zhihuijundexiaomidi/Smart_Cruise_Car/Control_handle/README.txt

20:25 2022/4/17
这是小车的掌心控制代码

14:04 2022/4/18
oled移植成功。但是库不完善，可以后续完善。

19:20 2022/4/18
MPU6050成功移植。硬件iic没有使用成功。可以先试试简单的硬件iic通信。

12:02 2022/4/19
MPU6050欧拉角获取成功，读取速度要快，不然会爆FIFO存储。300ms内
与oled联调测试完毕。

14:51 2022/4/19
硬件框架构建完成。

14:50 2022/4/25
2.4G通信优化移植成功。但是动态长度依旧没有配置成功。由于时间原因。暂不处理，
只配置静态的通信。

9:25 2022/4/27
手柄的通信命令已完成。小车只需检测收到的命令即可。
