zhihuijundexiaomidi/Smart_Cruise_Car/Smart_Cruise_Car.ioc

Mcu.UserName=STM32F103C8Tx
PA0-WKUP.GPIO_Label=TB6612_E1A
PA0-WKUP.Signal=S_TIM2_CH1_ETR
PA1.GPIO_Label=TB6612_E1B
PA1.Signal=S_TIM2_CH2
PA10.GPIO_Label=DEBUG_R
PA10.Signal=USART1_RX
PA11.GPIO_Label=SPI_CE
PA11.Signal=GPIO_Output
PA12.GPIO_Label=SPI_CSN
PA12.Signal=GPIO_Output
PA13.Signal=SYS_JTMS-SWDIO
PA14.Signal=SYS_JTCK-SWCLK
PA15.GPIO_Label=SPI_IRQ
PA15.Signal=GPIO_Input
PA2.Signal=USART2_TX
PA3.Signal=USART2_RX
PA4.Signal=ADCx_IN4
PA5.Signal=ADCx_IN5
PA6.GPIO_Label=motorA_PWM
PA6.Signal=S_TIM3_CH1
PA7.GPIO_Label=motorB_PWM
PA7.Signal=S_TIM3_CH2
PA8.GPIO_Label=steering_engine_PWM
PA8.Signal=S_TIM1_CH1
PA9.GPIO_Label=DEBUG_T
PA9.Signal=USART1_TX
PB0.GPIO_Label=infrared_sensor_left
PB0.Signal=GPXTI0
PB1.GPIO_Label=infrared_sensor_right
PB1.Signal=GPXTI1
PB10.Signal=USART3_TX
PB11.Signal=USART3_RX
PB12.GPIO_Label=TB6612_A1
PB12.Signal=GPIO_Output
PB13.GPIO_Label=TB6612_A0
PB13.Signal=GPIO_Output
PB14.GPIO_Label=TB6612_B1
PB14.Signal=GPIO_Output
PB15.GPIO_Label=TB6612_B0
PB15.Signal=GPIO_Output
PB3.Signal=SPI1_SCK
PB4.Signal=SPI1_MISO
PB5.Signal=SPI1_MOSI
PB6.GPIO_Label=TB6612_E2A
PB6.Signal=S_TIM4_CH1
PB7.GPIO_Label=TB6612_E2B
PB7.Signal=S_TIM4_CH2
PB8.Signal=I2C1_SCL
PB9.Signal=I2C1_SDA
PC13-TAMPER-RTC.GPIO_Label=LED
PC13-TAMPER-RTC.Signal=GPIO_Output
PD0-OSC_IN.Signal=RCC_OSC_IN
PD1-OSC_OUT.Signal=RCC_OSC_OUT
