zhihuijundexiaomidi/Smart_Cruise_Car/Core/Inc/main.h

#define LED_Pin GPIO_PIN_13
#define LED_GPIO_Port GPIOC
#define TB6612_E1A_Pin GPIO_PIN_0
#define TB6612_E1A_GPIO_Port GPIOA
#define TB6612_E1B_Pin GPIO_PIN_1
#define TB6612_E1B_GPIO_Port GPIOA
#define motorA_PWM_Pin GPIO_PIN_6
#define motorA_PWM_GPIO_Port GPIOA
#define motorB_PWM_Pin GPIO_PIN_7
#define motorB_PWM_GPIO_Port GPIOA
#define infrared_sensor_left_Pin GPIO_PIN_0
#define infrared_sensor_left_GPIO_Port GPIOB
#define infrared_sensor_left_EXTI_IRQn EXTI0_IRQn
#define infrared_sensor_right_Pin GPIO_PIN_1
#define infrared_sensor_right_GPIO_Port GPIOB
#define infrared_sensor_right_EXTI_IRQn EXTI1_IRQn
#define TB6612_A1_Pin GPIO_PIN_12
#define TB6612_A1_GPIO_Port GPIOB
#define TB6612_A0_Pin GPIO_PIN_13
#define TB6612_A0_GPIO_Port GPIOB
#define TB6612_B1_Pin GPIO_PIN_14
#define TB6612_B1_GPIO_Port GPIOB
#define TB6612_B0_Pin GPIO_PIN_15
#define TB6612_B0_GPIO_Port GPIOB
#define steering_engine_PWM_Pin GPIO_PIN_8
#define steering_engine_PWM_GPIO_Port GPIOA
#define DEBUG_T_Pin GPIO_PIN_9
#define DEBUG_T_GPIO_Port GPIOA
#define DEBUG_R_Pin GPIO_PIN_10
#define DEBUG_R_GPIO_Port GPIOA
#define SPI_CE_Pin GPIO_PIN_11
#define SPI_CE_GPIO_Port GPIOA
#define SPI_CSN_Pin GPIO_PIN_12
#define SPI_CSN_GPIO_Port GPIOA
#define SPI_IRQ_Pin GPIO_PIN_15
#define SPI_IRQ_GPIO_Port GPIOA
#define TB6612_E2A_Pin GPIO_PIN_6
#define TB6612_E2A_GPIO_Port GPIOB
#define TB6612_E2B_Pin GPIO_PIN_7
#define TB6612_E2B_GPIO_Port GPIOB
