zhihuijundexiaomidi/Smart_Cruise_Car/user/BSP/bsp_motor.c

#include "bsp_motor.h"  
#include "bsp_SG90.h"  
#include "bsp_encoder.h" 

int base_speed = 1000;
#define left_fix_speed 0
#define right_fix_speed 0
#define turn_fix_speed	60//转弯速度不够快。会跑出轨道

void forward_run(int TargetVelocity,int TargetCircle)
{
	F_RUN;
	steering_engine_PWM(950);//中间右极致
	PID_SET_SPEED(TargetVelocity,TargetCircle);
	left_wheel_speed(base_speed+left_fix_speed);
	right_wheel_speed(base_speed+right_fix_speed);
}

void back_run(int TargetVelocity,int TargetCircle)
{
	B_RUN;
	steering_engine_PWM(950);//中间右极致
	PID_SET_SPEED(TargetVelocity,TargetCircle);
	left_wheel_speed(base_speed+left_fix_speed);
	right_wheel_speed(base_speed+right_fix_speed);
}

void left_run(int TargetVelocity,int TargetCircle)
{
	LB_RUN;
	RF_RUN;
	steering_engine_PWM(600);//右极致
	PID_SET_SPEED(TargetVelocity,TargetCircle);
	left_wheel_speed(base_speed+left_fix_speed);
	right_wheel_speed(base_speed+right_fix_speed);
}

void right_run(int TargetVelocity,int TargetCircle)
{
	LF_RUN;
	RB_RUN;
	steering_engine_PWM(1600);//左极致
	PID_SET_SPEED(TargetVelocity,TargetCircle);
	left_wheel_speed(base_speed+left_fix_speed);
	right_wheel_speed(base_speed+right_fix_speed);
}

void car_stop()
{
	CAR_STOP;
	steering_engine_PWM(950);//中间极致
	PID_SET_SPEED(0,0);
	left_wheel_speed(0);
	right_wheel_speed(0);
}
