zhihuijundexiaomidi/Smart_Cruise_Car/Control_handle/user/BSP/bsp_oled096_spi.h

//////////////////////////////////////////////////////////////////////////////////	 
//              GND    电源地
//              VCC  接5V或3.3v电源
//              D0   接PA5（SCL）
//              D1   接PA7（SDA）
//              RES  接PB0
//              DC   接PB1
//              CS   接PA4               
//******************************************************************************/
#ifndef __bsp_oled096_spi_H
#define __bsp_oled096_spi_H			  	 
#include "main.h"
#include "stdlib.h"	 
  	
//OLED模式设置
//0:4线串行模式
//1:并行8080模式
#define OLED_MODE 0
#define SIZE 16
#define XLevelL		0x00
#define XLevelH		0x10
#define Max_Column	128
#define Max_Row		64
#define	Brightness	0xFF 
#define X_WIDTH 	128
#define Y_WIDTH 	64	    

//-----------------OLED端口定义----------------  					   


#define OLED_SCLK_Clr() HAL_GPIO_WritePin(OLED_SCLK_GPIO_Port,OLED_SCLK_Pin,GPIO_PIN_RESET)//CLK
#define OLED_SCLK_Set() HAL_GPIO_WritePin(OLED_SCLK_GPIO_Port,OLED_SCLK_Pin,GPIO_PIN_SET)

#define OLED_SDIN_Clr() HAL_GPIO_WritePin(OLED_SDIN_GPIO_Port,OLED_SDIN_Pin,GPIO_PIN_RESET)//DIN
#define OLED_SDIN_Set() HAL_GPIO_WritePin(OLED_SDIN_GPIO_Port,OLED_SDIN_Pin,GPIO_PIN_SET)

#define OLED_RST_Clr()  HAL_GPIO_WritePin(OLED_RET_GPIO_Port,OLED_RET_Pin,GPIO_PIN_RESET)//RES
#define OLED_RST_Set()  HAL_GPIO_WritePin(OLED_RET_GPIO_Port,OLED_RET_Pin,GPIO_PIN_SET)

#define OLED_DC_Clr()   HAL_GPIO_WritePin(OLED_DC_GPIO_Port,OLED_DC_Pin,GPIO_PIN_RESET)//DC
#define OLED_DC_Set()   HAL_GPIO_WritePin(OLED_DC_GPIO_Port,OLED_DC_Pin,GPIO_PIN_SET)
 		     
#define OLED_CS_Clr()   HAL_GPIO_WritePin(OLED_CS_GPIO_Port,OLED_CS_Pin,GPIO_PIN_RESET)//CS
#define OLED_CS_Set()   HAL_GPIO_WritePin(OLED_CS_GPIO_Port,OLED_CS_Pin,GPIO_PIN_SET)

#define OLED_CMD  0	//写命令
#define OLED_DATA 1	//写数据
//-----------------OLEDcmd指令定义----------------  
#define SetColumnAddress (0x21)//设置列地址
#define SetPageAddress (0X22)//设置页面地址

//OLED控制用函数
void OLED_WR_Byte(u8 dat,u8 cmd);	    
void OLED_Display_On(void);
void OLED_Display_Off(void);	   							   		    
void OLED_Init(void);
void OLED_Clear(void);
void OLED_DrawPoint(u8 x,u8 y,u8 t);
void OLED_Fill(u8 x1,u8 y1,u8 x2,u8 y2,u8 dot);
void OLED_ShowChar(u8 x,u8 y,u8 chr, u8 size);
void OLED_ShowNum(u8 x,u8 y,u32 num,u8 len,u8 size);
void OLED_ShowString(u8 x,u8 y,u8 *chr,u8 size);	 
void OLED_Set_Pos(unsigned char x, unsigned char y);
void OLED_ShowCHinese(u8 x,u8 y,u8 no);
void OLED_DrawBMP(unsigned char x0, unsigned char y0,unsigned char x1, unsigned char y1,unsigned char BMP[]);
#endif  
	 
