zhihuijundexiaomidi/Smart_Cruise_Car/Control_handle/user/BSP/bsp_led.h

#ifndef _BSP_LED_H
#define	_BSP_LED_H

#include "main.h"

#define led_on					 HAL_GPIO_WritePin(GPIOC, GPIO_PIN_13, GPIO_PIN_RESET);//引脚电平拉低，点亮
#define led_off          HAL_GPIO_WritePin(GPIOC, GPIO_PIN_13, GPIO_PIN_SET);//引脚电平拉高，熄灭

typedef enum
{
  led_ok = 1u,
  led_time_err,
} led_err_t;

led_err_t led_twinkle(int time);

#endif /* __LED_H */
