zhihuijundexiaomidi/Smart_Cruise_Car/(commit log)

2022-04-25 2.4g 通信完成
2022-04-25 手柄的2.4G通信完成
2022-04-25 论文参考文献修改完毕
2022-04-27 手柄的操控命令逻辑完成
2022-04-27 手柄部分代码完成。再有问题，一定是硬件问题。
2022-04-27 遥控手柄部分代码完成。小车遥控测试没有问题。如果出现问题，一定是硬件问题。
2022-04-30 论文完成
